ieb/N2KEngineEsp32/pcb/esp32board/esp32board.kicad_pcb

## KiCad design pcb/esp32board/esp32board.kicad_pcb (2026-10-11)

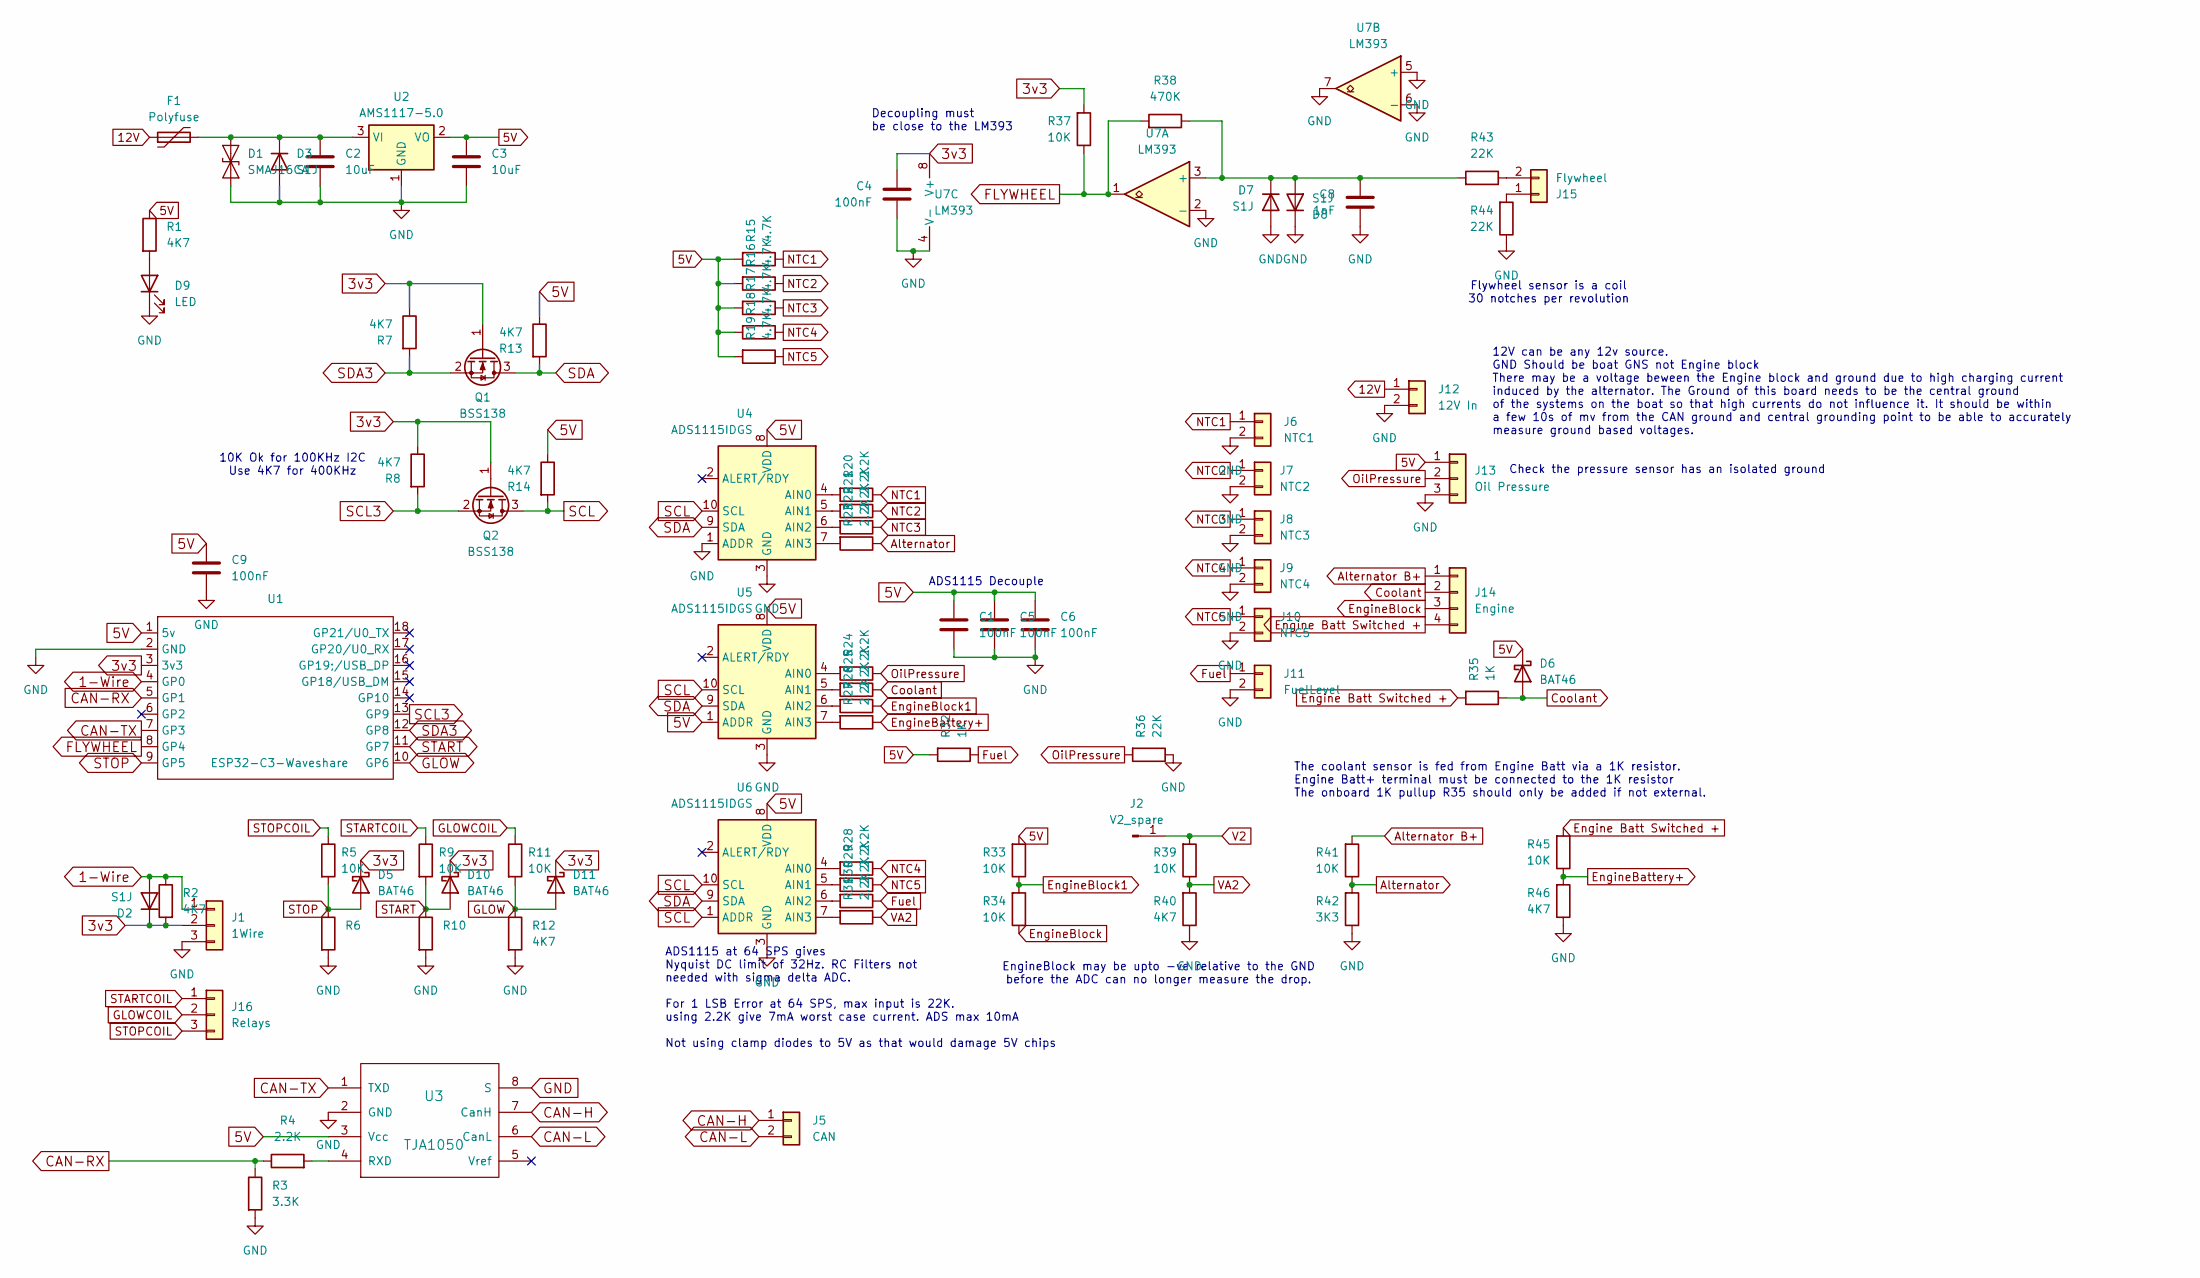
[picture p1: schematic esp32board.kicad_sch]

Parts:
C1, C4, C5, C6, C9: 100nF; C_0805_2012Metric_Pad1.18x1.45mm_HandSolder
C2, C3: 10uF; C_1206_3216Metric_Pad1.33x1.80mm_HandSolder
C8: 1nF; C_0805_2012Metric_Pad1.18x1.45mm_HandSolder
D1: SMAJ16CA; D_SMA-SMB_Universal_Handsoldering
D2, D3, D7, D8: S1J; D_SMA
D5, D6, D10, D11: BAT46; D_SOD-123
D9: LED; LED_0805_2012Metric_Pad1.15x1.40mm_HandSolder
F1: Polyfuse; Fuse_1812_4532Metric_Pad1.30x3.40mm_HandSolder
J1: 1Wire; JST_XH_B3B-XH-A_1x03_P2.50mm_Vertical
J2: V2_spare; PinHeader_1x01_P2.54mm_Vertical
J5: CAN; TerminalBlock_Phoenix_MKDS-1,5-2-5.08_1x02_P5.08mm_Horizont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
J6: NTC1; JST_XH_B2B-XH-A_1x02_P2.50mm_Vertical
J7: NTC2; JST_XH_B2B-XH-A_1x02_P2.50mm_Vertical
J8: NTC3; JST_XH_B2B-XH-A_1x02_P2.50mm_Vertical
J9: NTC4; JST_XH_B2B-XH-A_1x02_P2.50mm_Vertical
J10: NTC5; JST_XH_B2B-XH-A_1x02_P2.50mm_Vertical
J11: FuelLevel; JST_XH_B2B-XH-A_1x02_P2.50mm_Vertical
J12: 12V In; JST_XH_B2B-XH-A_1x02_P2.50mm_Vertical
J13: Oil Pressure; JST_XH_B3B-XH-A_1x03_P2.50mm_Vertical
J14: Engine; JST_XH_B4B-XH-A_1x04_P2.50mm_Vertical
J15: Flywheel; JST_XH_B2B-XH-A_1x02_P2.50mm_Vertical
J16: Relays; JST_XH_B3B-XH-A_1x03_P2.50mm_Vertical
Q1, Q2: BSS138; SOT-23
R1, R2, R6, R7, R8, R10, R12, R13, R14, R40, R46: 4K7; R_0805_2012Metric_Pad1.20x1.40mm_HandSolder
R3: 3.3K; R_0805_2012Metric_Pad1.20x1.40mm_HandSolder
R4, R20, R21, R22, R23, R24, R25, R26, R27, R28, R29, R30, R31: 2.2K; R_0805_2012Metric_Pad1.20x1.40mm_HandSolder
R5, R9, R11, R33, R34, R37, R39, R41, R45: 10K; R_0805_2012Metric_Pad1.20x1.40mm_HandSolder
R15, R16, R17, R18, R19: 4.7K; R_0805_2012Metric_Pad1.20x1.40mm_HandSolder
R32: 1K; R_0805_2012Metric_Pad1.20x1.40mm_HandSolder
R35: 1K; R_Axial_DIN0204_L3.6mm_D1.6mm_P5.08mm_Horizontal
R36, R43, R44: 22K; R_0805_2012Metric_Pad1.20x1.40mm_HandSolder
R38: 470K; R_0805_2012Metric_Pad1.20x1.40mm_HandSolder
R42: 3K3; R_0805_2012Metric_Pad1.20x1.40mm_HandSolder
U1: ESP32-C3-Waveshare; ESP-C3-Zero-Waveshare
U2: AMS1117-5.0; SOT-223-3_TabPin2
U3: TJA1050; SOIC-8_3.9x4.9mm_P1.27mm
U4, U5, U6: ADS1115IDGS; TSSOP-10_3x3mm_P0.5mm
U7: LM393; SOIC-8_3.9x4.9mm_P1.27mm

Connections:
1-Wire: D2.2 (A), J1.1, R2.1, U1.4 (GP0)
3v3: C4.2, D2.1 (K), D5.1 (K), D10.1 (K), D11.1 (K), J1.2, Q1.1 (G), Q2.1 (G), R2.2, R7.1, R8.1, R37.2, U1.3 (3v3), U7.8 (V+)
5V: C1.1, C3.1, C5.1, C6.1, C9.1, D6.1 (K), J13.1, R1.1, R13.1, R14.1, R15.2, R16.2, R17.2, R18.2, R19.2, R32.2, R33.2, U1.1 (5v), U2.2 (VO), U3.3 (Vcc), U4.8 (VDD), U5.1 (ADDR), U5.8 (VDD), U6.8 (VDD)
12V: F1.1, J12.1
Alternator: R23.1, R41.1, R42.2
Alternator B+: J14.1, R41.2
CAN-H: J5.1, U3.7 (CanH)
CAN-L: J5.2, U3.6 (CanL)
CAN-RX: R3.1, R4.1, U1.5 (GP1)
CAN-TX: U1.7 (GP3), U3.1 (TXD)
Coolant: D6.2 (A), J14.2, R25.1, R35.1
Engine Batt Switched +: J14.4, R35.2, R45.2
EngineBattery+: R27.1, R45.1, R46.2
EngineBlock: J14.3, R34.1
EngineBlock1: R26.1, R33.1, R34.2
FLYWHEEL: R37.1, R38.2, U1.8 (GP4), U7.1
Fuel: J11.1, R30.1, R32.1
GLOW: D11.2 (A), R11.2, R12.1, U1.10 (GP6)
GLOWCOIL: J16.2, R11.1
GND: C1.2, C2.2, C3.2, C4.1, C5.2, C6.2, C8.1, C9.2, D1.1 (A1), D3.2 (A), D7.2 (A), D8.1 (K), D9.1 (K), J1.3, J6.2, J7.2, J8.2, J9.2, J10.2, J11.2, J12.2, J13.3, R3.2, R6.2, R10.2, R12.2, R36.1, R40.1, R42.1, R44.1, R46.1, U1.2 (GND), U2.1 (GND), U3.2 (GND), U3.8 (S), U4.1 (ADDR), U4.3 (GND), U5.3 (GND), U6.3 (GND), U7.2 (-), U7.4 (V-), U7.5 (+), U7.6 (-), U7.7
NTC1: J6.1, R15.1, R20.1
NTC2: J7.1, R16.1, R21.1
NTC3: J8.1, R17.1, R22.1
NTC4: J9.1, R18.1, R28.1
NTC5: J10.1, R19.1, R29.1
unnamed: C2.1, D1.2 (A2), D3.1 (K), F1.2, U2.3 (VI)
unnamed: C8.2, D7.1 (K), D8.2 (A), R38.1, R43.2, U7.3 (+)
unnamed: D9.2 (A), R1.2
unnamed: J15.1, R44.2
unnamed: J15.2, R43.1
unnamed: R4.2, U3.4 (RXD)
unnamed: R20.2, U4.4 (AIN0)
unnamed: R21.2, U4.5 (AIN1)
unnamed: R22.2, U4.6 (AIN2)
unnamed: R23.2, U4.7 (AIN3)
unnamed: R24.2, U5.4 (AIN0)
unnamed: R25.2, U5.5 (AIN1)
unnamed: R26.2, U5.6 (AIN2)
unnamed: R27.2, U5.7 (AIN3)
unnamed: R28.2, U6.4 (AIN0)
unnamed: R29.2, U6.5 (AIN1)
unnamed: R30.2, U6.6 (AIN2)
unnamed: R31.2, U6.7 (AIN3)
OilPressure: J13.2, R24.1, R36.2
SCL: Q2.3 (D), R14.2, U4.10 (SCL), U5.10 (SCL), U6.1 (ADDR), U6.10 (SCL)
SCL3: Q2.2 (S), R8.2, U1.13 (GP9)
SDA: Q1.3 (D), R13.2, U4.9 (SDA), U5.9 (SDA), U6.9 (SDA)
SDA3: Q1.2 (S), R7.2, U1.12 (GP8)
START: D10.2 (A), R9.2, R10.1, U1.11 (GP7)
STARTCOIL: J16.1, R9.1
STOP: D5.2 (A), R5.2, R6.1, U1.9 (GP5)
STOPCOIL: J16.3, R5.1
V2: J2.1, R39.2
VA2: R31.1, R39.1, R40.2

Notes on the sheet:
ADS1115 at 64 SPS gives Nyquist DC limit of 32Hz. RC Filters not needed with sigma delta ADC. For 1 LSB Error at 64 SPS, max input is 22K. using 2.2K give 7mA worst case current. ADS max 10mA Not using clamp diodes to 5V as that would damage 5V chips
ADS1115 Decouple
Flywheel sensor is a coil 30 notches per revolution
Decoupling must be close to the LM393
EngineBlock may be upto -ve relative to the GND before the ADC can no longer measure the drop.
10K Ok for 100KHz I2C Use 4K7 for 400KHz
The coolant sensor is fed from Engine Batt via a 1K resistor. Engine Batt+ terminal must be connected to the 1K resistor The onboard 1K pullup R35 should only be added if not external.
Check the pressure sensor has an isolated ground
12V can be any 12v source. GND Should be boat GNS not Engine block There may be a voltage beween the Engine block and ground due to high charging current induced by the alternator. The Ground of this board needs to be the central ground of the systems on the boat so that high currents do not influe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

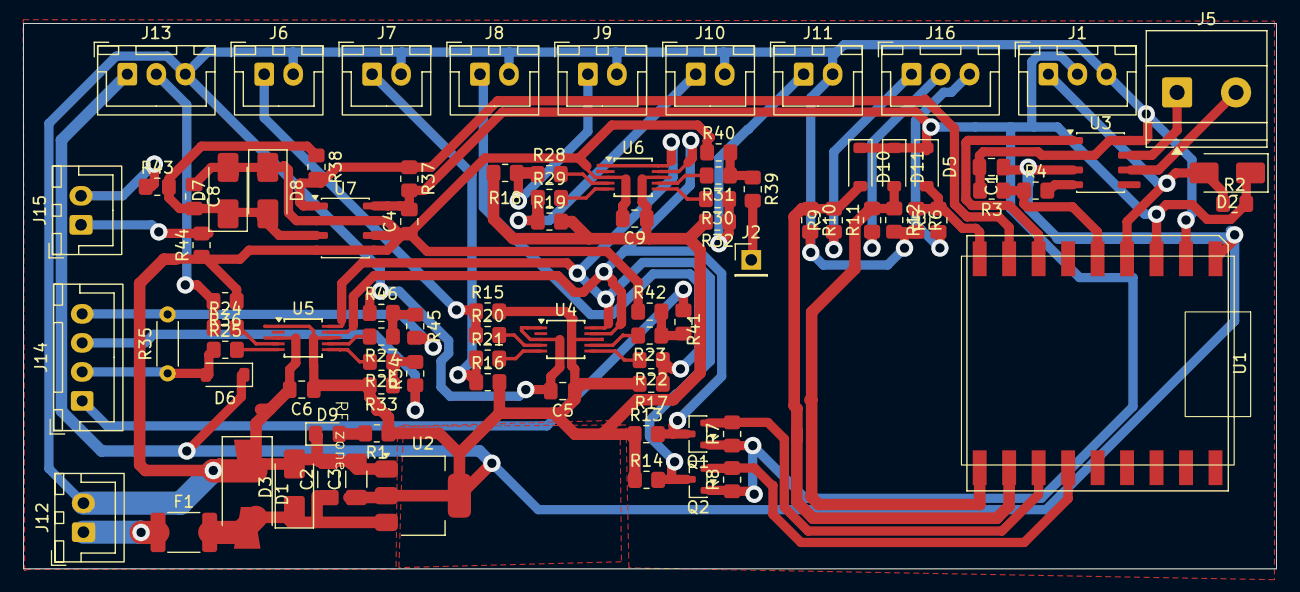
[picture p2: board esp32board.kicad_pcb from above]

Board: 2 copper layers, 108.0 x 47.0 mm, 88 parts (0 on the bottom side), 54 nets.
