ieb/N2KEngineEsp32/test/N2kMsg.h

#pragma once
#include <cstdint>

#define N2kDoubleNA   -1e9
#define N2kInt8NA     0x7f
#define N2kUInt8NA    0xff
#define N2kInt16NA    0x7fff
#define N2kUInt16NA   0xffff
#define N2kUInt32NA   0xffffffff

typedef uint16_t tN2kEngineDiscreteStatus1;
typedef uint16_t tN2kEngineDiscreteStatus2;
