ieb/N2KEngineEsp32/(commit log)

2026-10-10 Frist pass at pcb
    [esp32board.kicad_pcb, esp32board.kicad_sch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]
2026-10-10 Implementation first pass
    [no_ota.csv]
2026-10-11 Fixed some hardware problems, new board
    [esp32board.kicad_pcb, esp32board.kicad_sch]
2026-10-11 Fixed some hardware problems
    [esp32board.kicad_pcb, esp32board.kicad_sch]
2026-10-11 Fixed final hardware adjustments
    [esp32board.kicad_pcb, esp32board.kicad_sch]
2026-10-12 Improved RPM sensor
2026-10-12 eliminated flash writes to avoid interupt failures
    [Preferences.h, StorageManager.cpp, StorageManager.h, config.h, main.cpp, test_main.cpp]
